yuansco/STM32G070-EVB/Demo/STM32CubeMX/Eeprom/Core/Inc/main.h

#define LED_BLUE_Pin GPIO_PIN_13
#define LED_BLUE_GPIO_Port GPIOC
#define LED_RED_Pin GPIO_PIN_0
#define LED_RED_GPIO_Port GPIOA
#define BUTTON_1_Pin GPIO_PIN_6
#define BUTTON_1_GPIO_Port GPIOC
#define BUTTON_2_Pin GPIO_PIN_7
#define BUTTON_2_GPIO_Port GPIOC
