yuansco/STM32G070-EVB/(notices)

Notices in the files:
Demo/STM32CubeMX/Eeprom/Core/Inc/main.h:
Copyright (c) 2022 STMicroelectronics.
All rights reserved.
This software is licensed under terms that can be found in the LICENSE file
